viayulo/nand_programmer/gerber/adapter_soic8_solder_designator.pdf

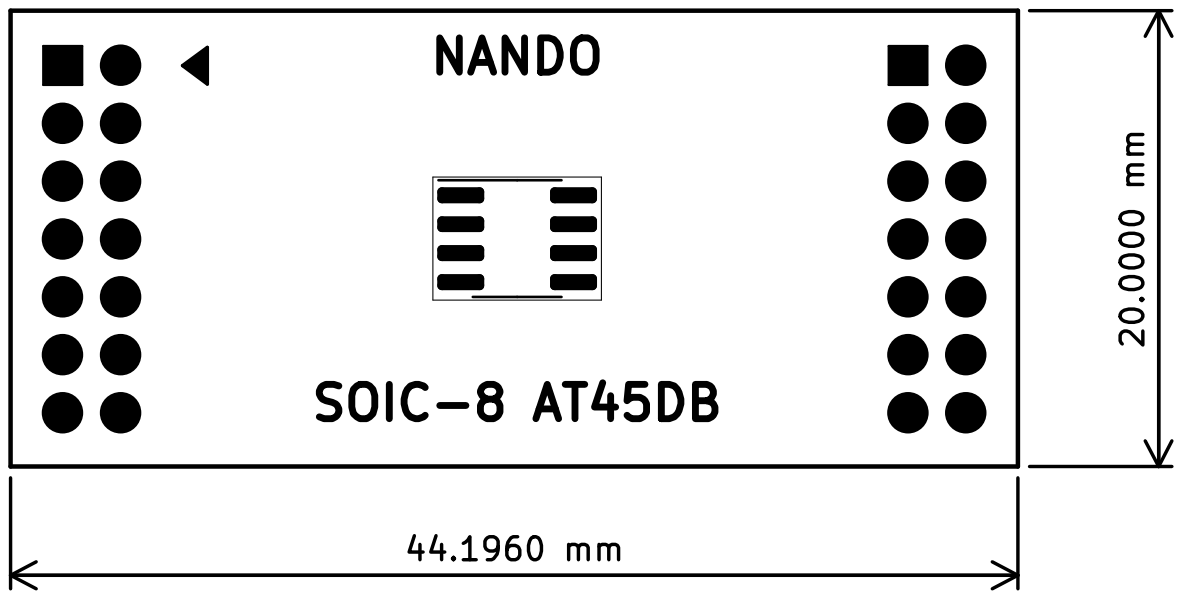
[picture p1: page 1]
