viayulo/nand_programmer/gerber/adapter_tsop48_designator.pdf

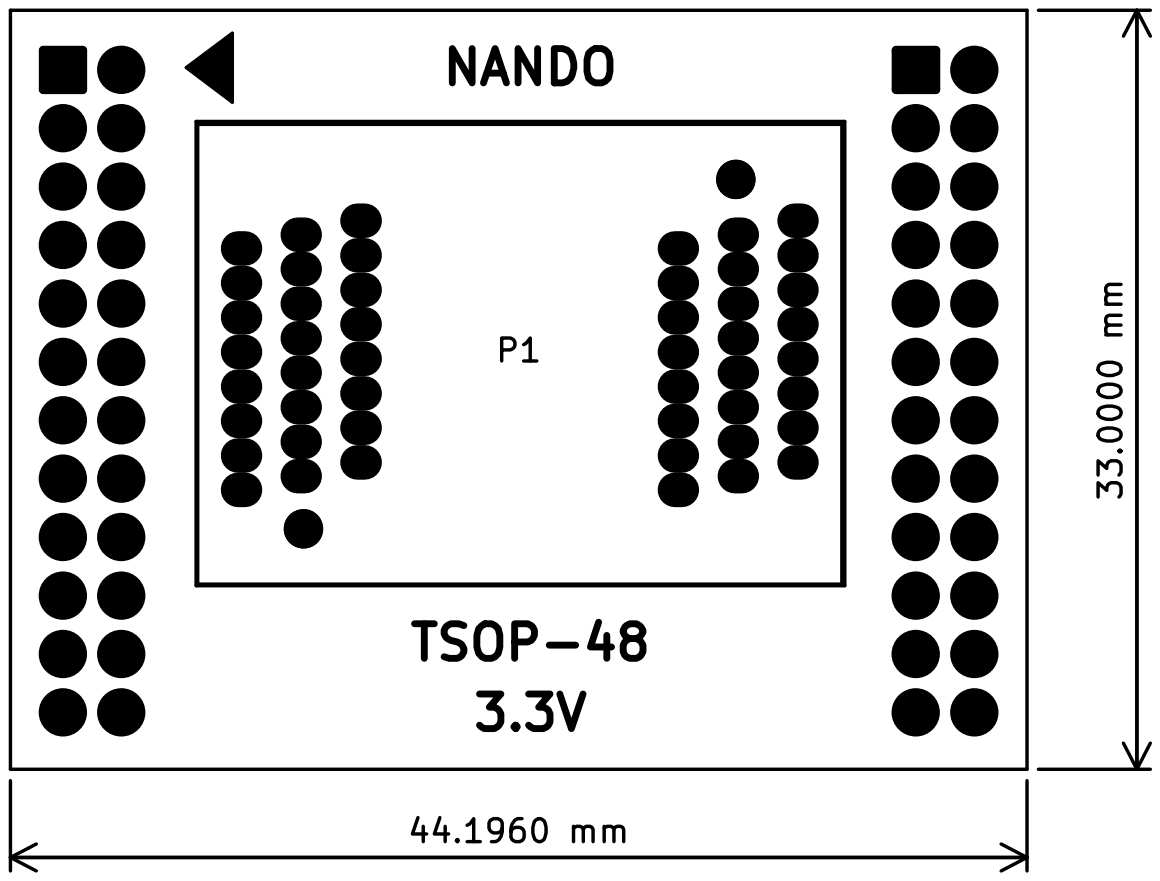
[picture p2: page 1]
