viayulo/nand_programmer/gerber/adapter_tsop48_solder_designator.pdf

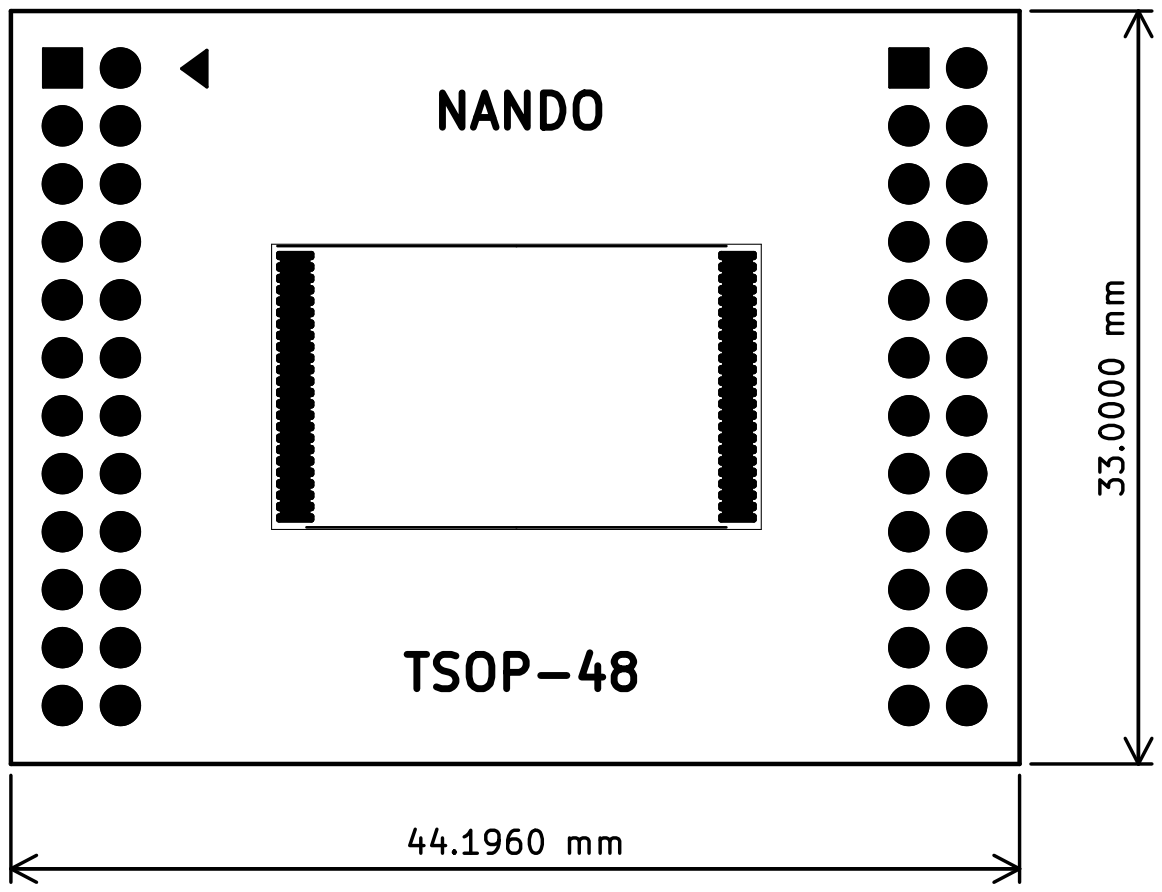
[picture p3: page 1]
