viayulo/nand_programmer/gerber/nand_programmator_designator.pdf

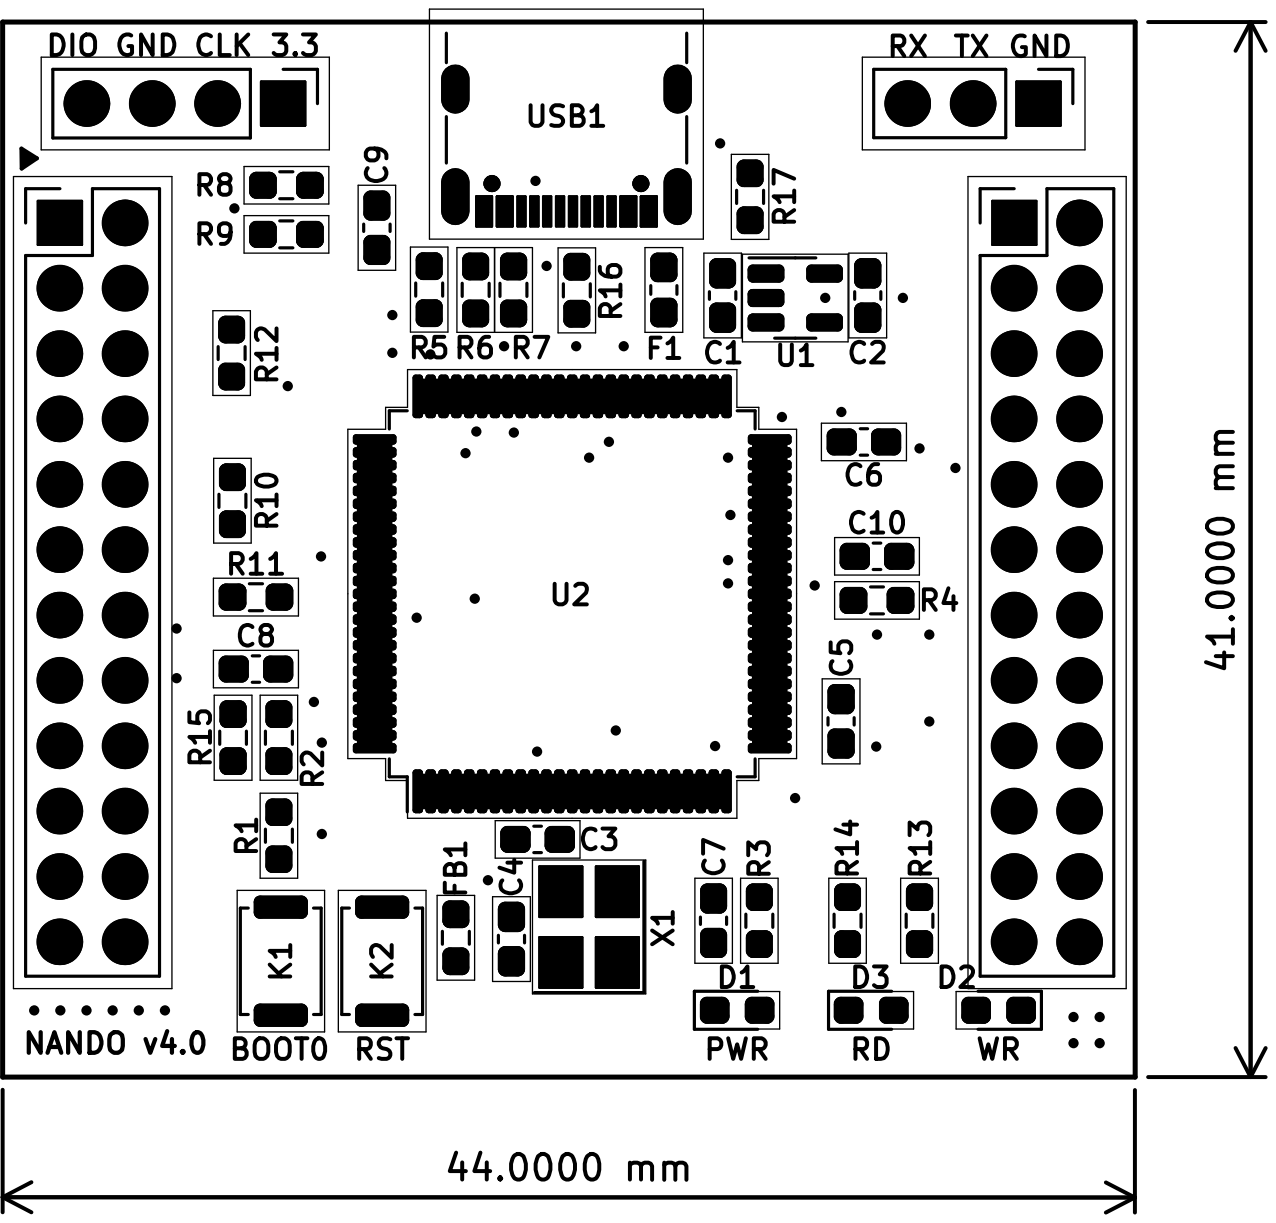
[picture p4: page 1]
